RainbowLabsDE/PowerMeasure_1Ph/README.md

# PowerMeasure_1Ph

this repo is still undergoing major changes and should not yet be rebuilt
