RainbowLabsDE/PowerMeasure_1Ph/Doku/FrontpanelIdee.jpg

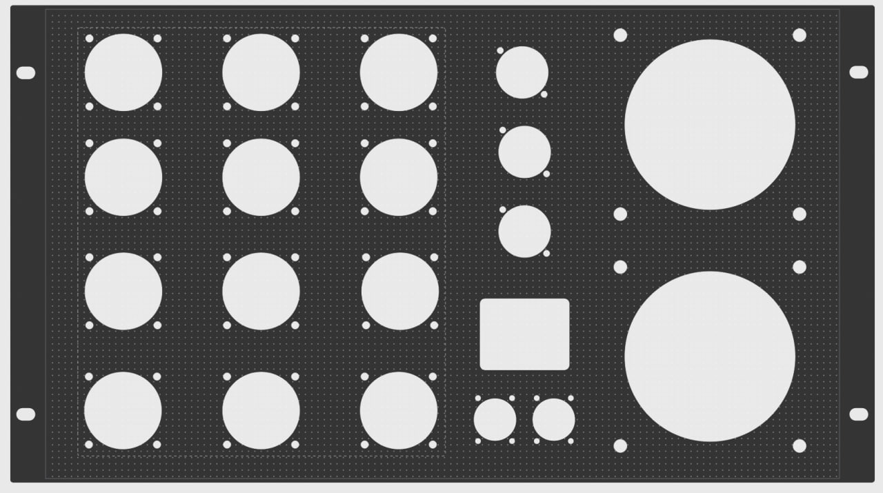
Doku/FrontpanelIdee.jpg
