RainbowLabsDE/PowerMeasure_1Ph/Hardware/PCB_umrissV3.dxf

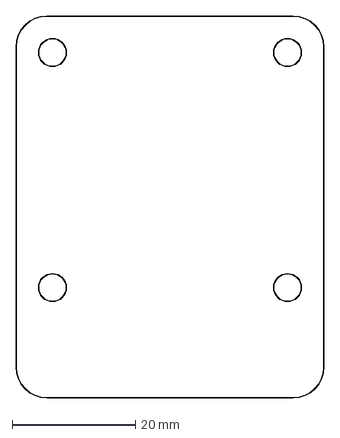
[picture p4: CAD file, 2024-11-22]
Hardware/PCB_umrissV3.dxf
50.0 x 62.0 mm
