RainbowLabsDE/PowerMeasure_1Ph/Mechanik/Plug-CEE-5pin-16A-Mannekes (Розетка типа CEE5pin 16A Female).IGS

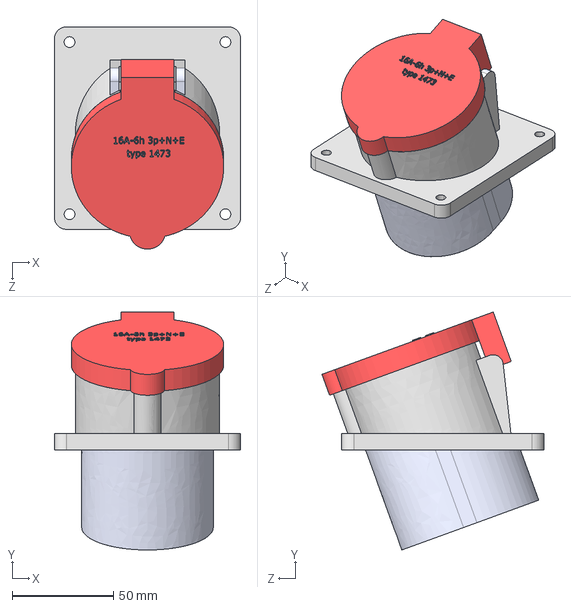
[picture p5: CAD file, 2024-11-22]
Mechanik/Plug-CEE-5pin-16A-Mannekes (Розетка типа CEE5pin 16A Female).IGS
92.0 x 117.5 x 109.7 mm
