RainbowLabsDE/PowerMeasure_1Ph/Hardware/ne8fbh-1.stp

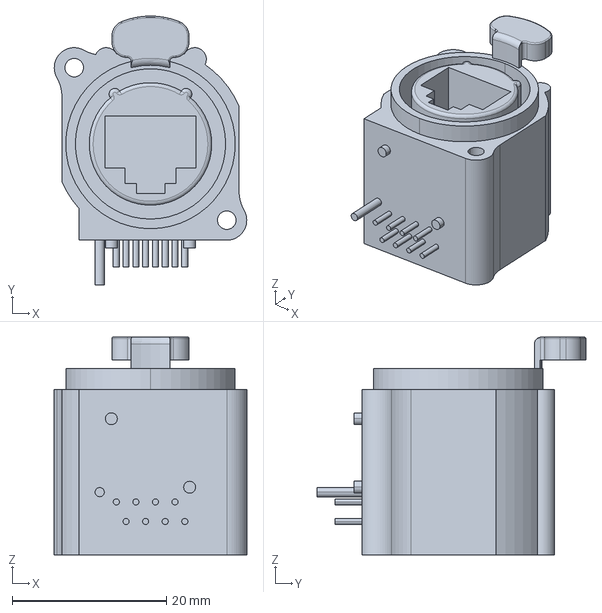
[picture p6: CAD file, 2024-11-22]
Hardware/ne8fbh-1.stp
25.0 x 34.9 x 28.3 mm
