RainbowLabsDE/PowerMeasure_1Ph/Mechanik/Einbaudose Typ 13 230V_10A IP54.STEP

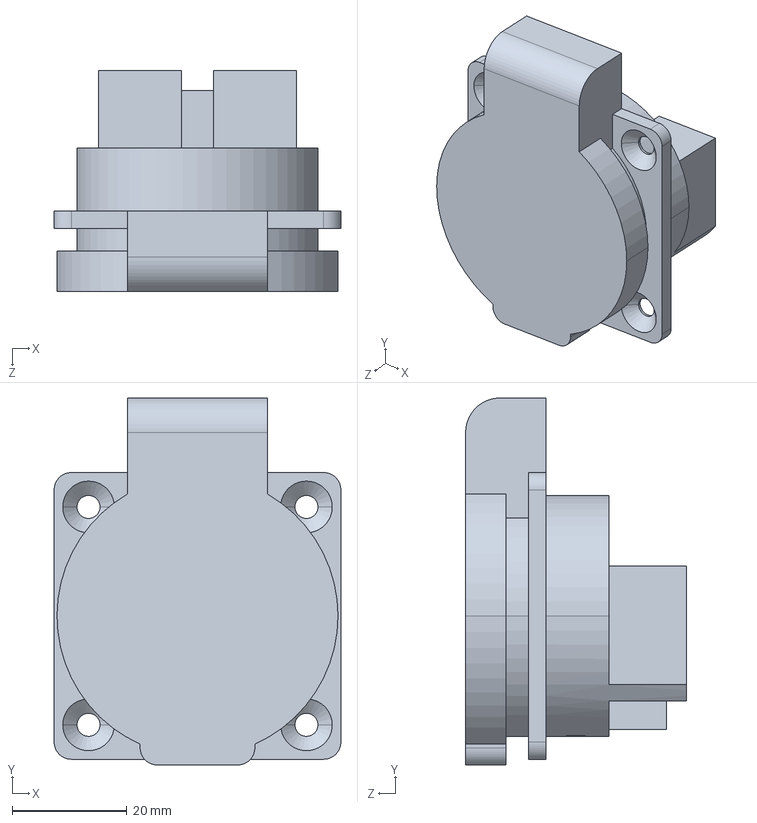
[picture p7: CAD file, 2024-11-22]
Mechanik/Einbaudose Typ 13 230V_10A IP54.STEP
50.0 x 64.0 x 38.5 mm
