RainbowLabsDE/PowerMeasure_1Ph/Mechanik/FI_LS_C13_30mA.STEP

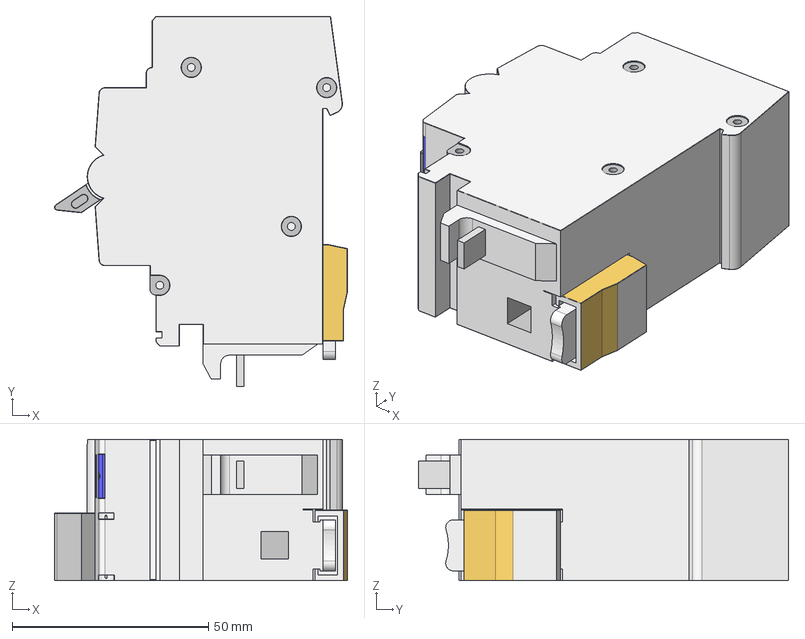
[picture p8: CAD file, 2024-11-22]
Mechanik/FI_LS_C13_30mA.STEP
74.6 x 94.3 x 36.0 mm
