RainbowLabsDE/PowerMeasure_1Ph/Hardware/NAC3FPX-WOT-TOP.stp

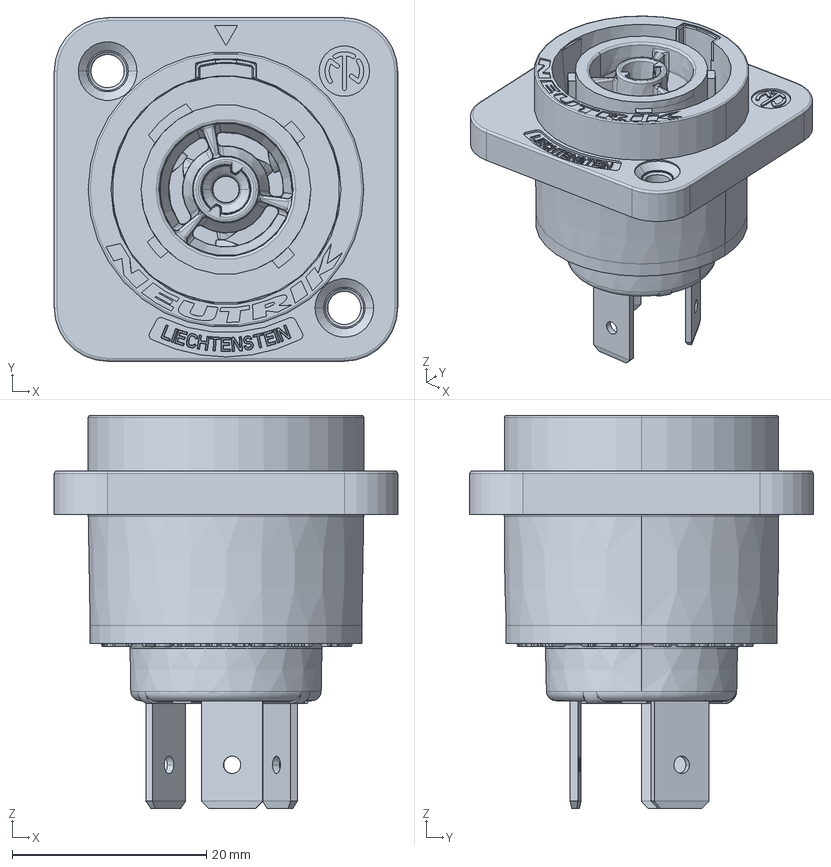
[picture p9: CAD file, 2024-11-22]
Hardware/NAC3FPX-WOT-TOP.stp
35.4 x 35.4 x 40.5 mm
