RainbowLabsDE/PowerMeasure_1Ph/Hardware/VAC v2.step

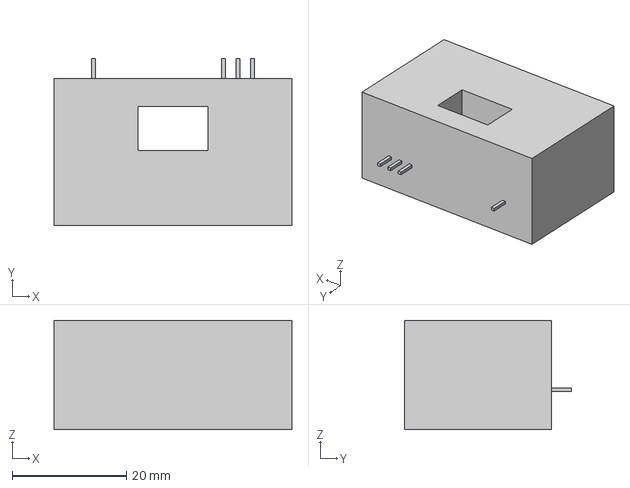
[picture p10: CAD file, 2024-11-22]
Hardware/VAC v2.step
41.8 x 29.3 x 19.2 mm
