RainbowLabsDE/PowerMeasure_1Ph/Hardware/Körper1.stl

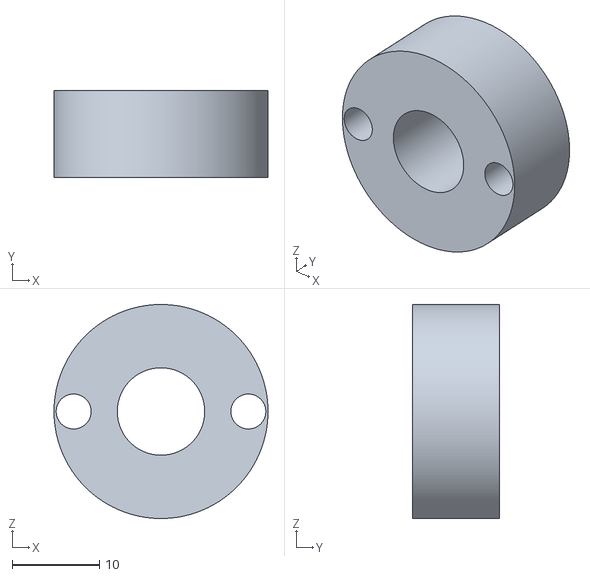
[picture p11: CAD file, 2024-11-22]
Hardware/Körper1.stl
24.5 x 10.0 x 24.5
