RainbowLabsDE/PowerMeasure_1Ph/Hardware/PCB_umriss.dxf

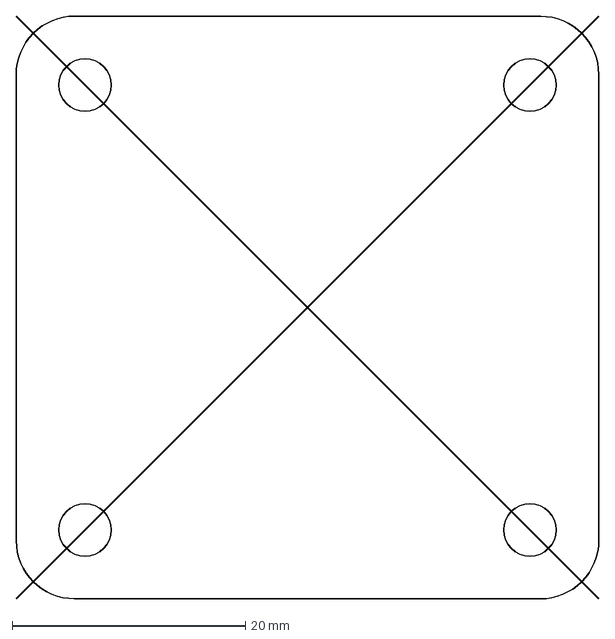
[picture p12: CAD file, 2024-11-22]
Hardware/PCB_umriss.dxf
50.0 x 50.0 mm
