RainbowLabsDE/PowerMeasure_1Ph/Hardware/EPR1200043B SSD1303 OLED bent 1.6mm.step

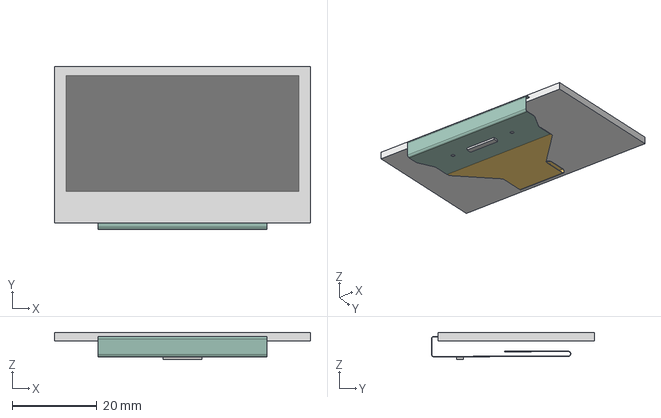
[picture p13: CAD file, 2024-11-22]
Hardware/EPR1200043B SSD1303 OLED bent 1.6mm.step
60.5 x 38.6 x 6.38 mm
