RainbowLabsDE/PowerMeasure_1Ph/Hardware/PCB_umrissV2.dxf

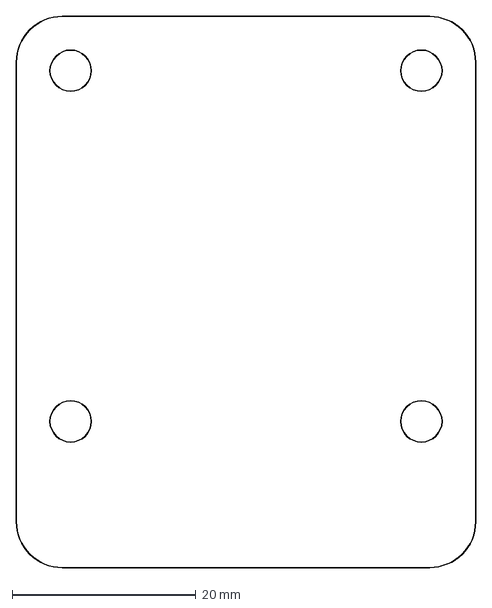
[picture p14: CAD file, 2024-11-22, an earlier design]
Hardware/PCB_umrissV2.dxf
50.0 x 60.0 mm
