RainbowLabsDE/PowerMeasure_1Ph/Hardware/Powermeter1P1I.kicad_pcb

## KiCad design Hardware/Powermeter1P1I.kicad_pcb (2025-05-22)

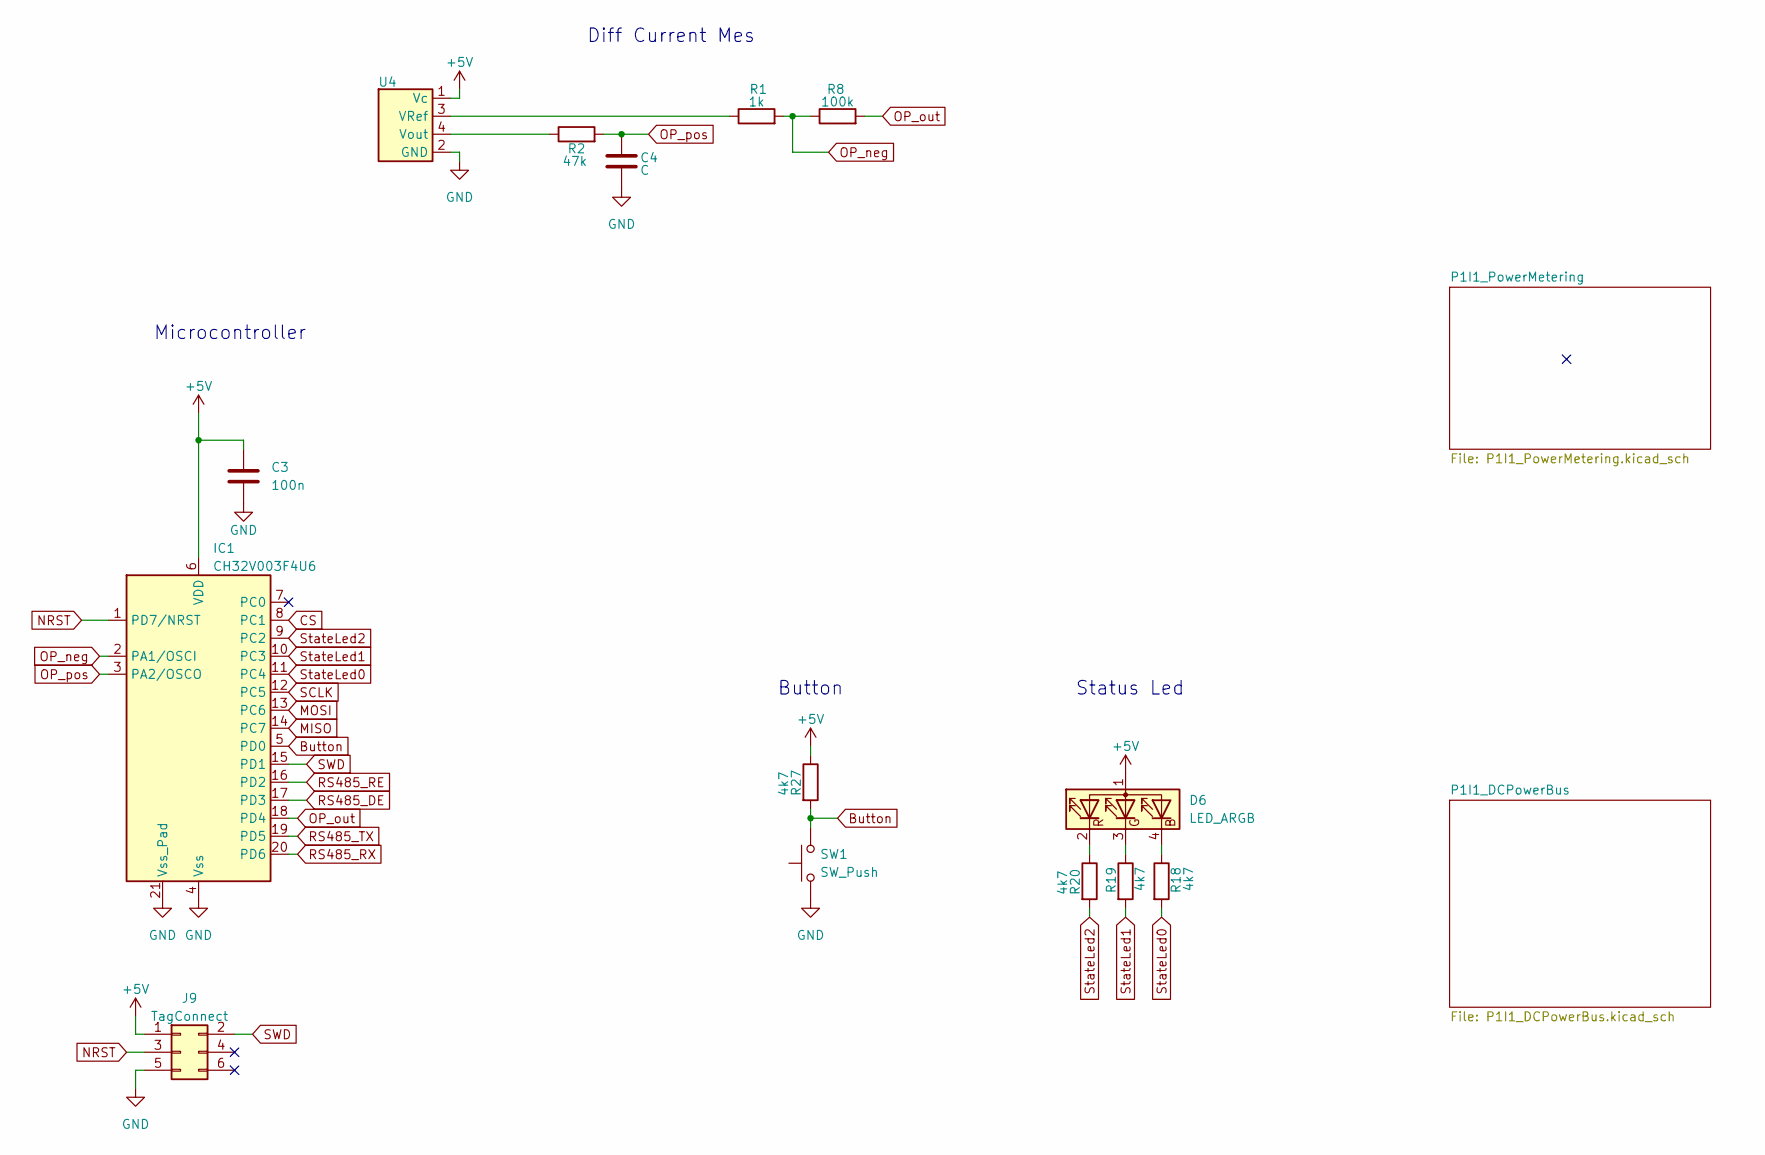
[picture p18: schematic Powermeter1P1I.kicad_sch]

Parts:
C3: 100n; C_0402_1005Metric
C4: C; C_0402_1005Metric
D6: LED_ARGB; LED-ARRAY-SMD_MHS110FRGBCT
IC1: CH32V003F4U6; QFN-20-1EP_3x3mm_P0.4mm_EP1.65x1.65mm_ThermalVias
J9: TagConnect; Tag-Connect_TC2030-IDC-NL_2x03_P1.27mm_Vertical
R1: 1k; R_0402_1005Metric
R2: 47k; R_0402_1005Metric
R8: 100k; R_0402_1005Metric
R18, R19, R20, R27: 4k7; R_0402_1005Metric
SW1: SW_Push; SW-SMD_TS24CA
U4: VACDiff

Connections:
+5V: C3.1, D6.1 (A), IC1.6 (VDD), J9.1, R27.1, U4.1 (Vc); also elsewhere on the board
Button: IC1.5 (PD0), R27.2, SW1.2
CS: IC1.8 (PC1); also elsewhere on the board
GND: C3.2, C4.2, IC1.4 (Vss), IC1.21 (Vss_Pad), J9.5, SW1.1, U4.2 (GND); also elsewhere on the board
MISO: IC1.14 (PC7); also elsewhere on the board
MOSI: IC1.13 (PC6); also elsewhere on the board
NRST: IC1.1 (PD7/NRST), J9.3
unnamed: D6.4 (BK), R18.1
unnamed: D6.3 (GK), R19.1
unnamed: D6.2 (RK), R20.1
unnamed: R1.1, U4.3 (VRef)
unnamed: R2.1, U4.4 (Vout)
OP_neg: IC1.2 (PA1/OSCI), R1.2, R8.1
OP_out: IC1.18 (PD4), R8.2
OP_pos: C4.1, IC1.3 (PA2/OSCO), R2.2
RS485_DE: IC1.17 (PD3); also elsewhere on the board
RS485_RE: IC1.16 (PD2); also elsewhere on the board
RS485_RX: IC1.20 (PD6); also elsewhere on the board
RS485_TX: IC1.19 (PD5); also elsewhere on the board
SCLK: IC1.12 (PC5); also elsewhere on the board
SWD: IC1.15 (PD1), J9.2
StateLed0: IC1.11 (PC4), R18.2
StateLed1: IC1.10 (PC3), R19.2
StateLed2: IC1.9 (PC2), R20.2

Notes on the sheet:
Status Led
Microcontroller
Button
Diff Current Mes

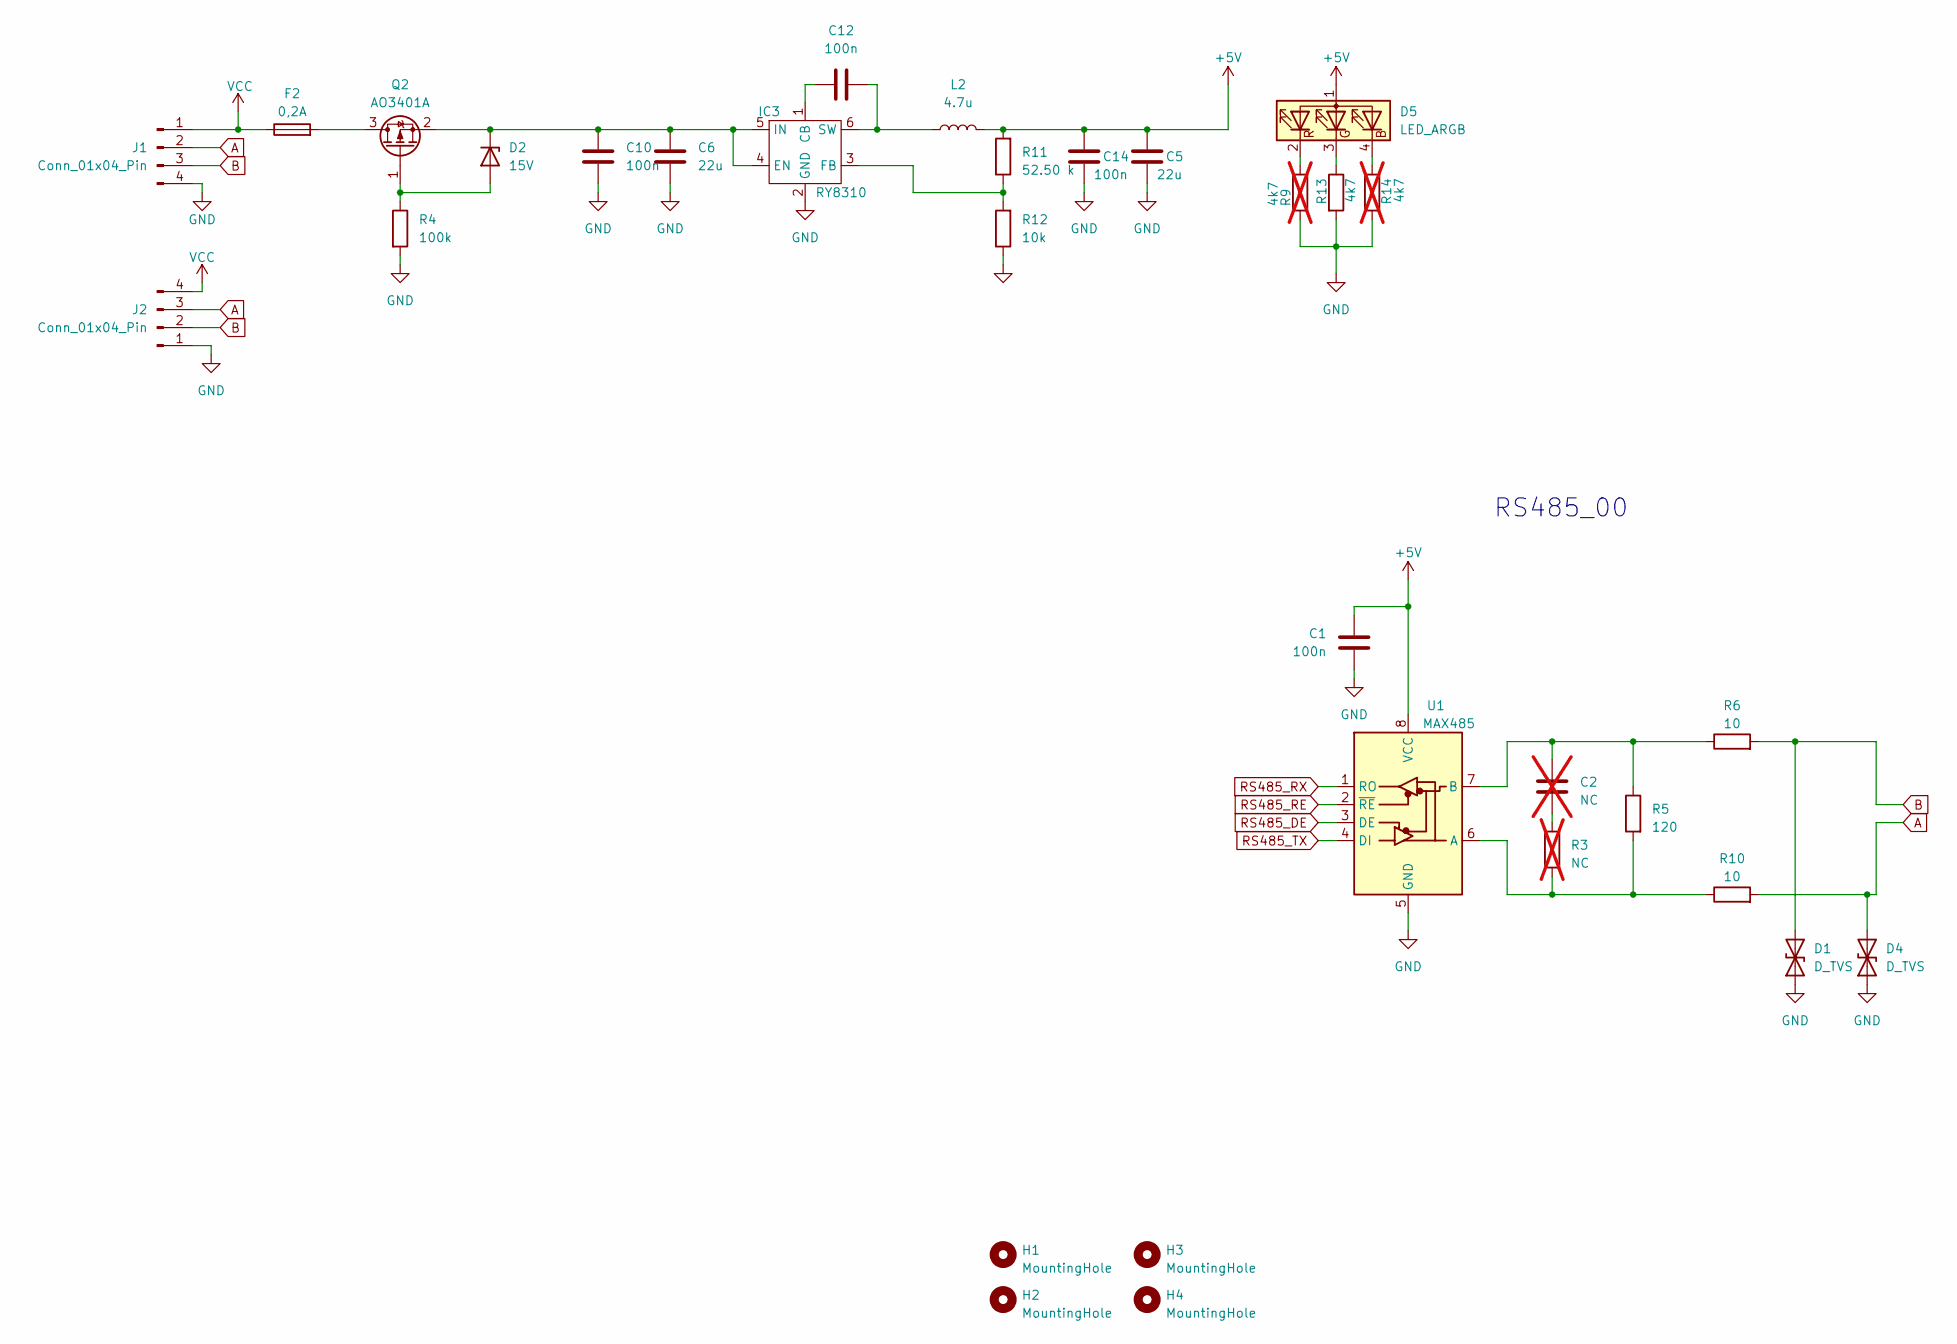
[picture p19: schematic P1I1_DCPowerBus.kicad_sch]

Parts:
C1, C10, C12, C14: 100n; C_0402_1005Metric
C2: NC; C_0402_1005Metric; not fitted
C5, C6: 22u; C_1210_3225Metric
D1, D4: D_TVS; D_0402_1005Metric
D2: 15V; D_SOD-323
D5: LED_ARGB; LED-ARRAY-SMD_MHS110FRGBCT
F2: 0,2A; Fuse_0603_1608Metric
H1, H2, H3, H4: MountingHole; MountingHole_4.3mm_M4
IC3: RY8310; SOT-23-6
J1, J2: Conn_01x04_Pin; CONN-SMD_HCZZ0451-4
L2: 4.7u; IND-SMD_L2.0-W1.6
Q2: AO3401A; TSOT-23
R3: NC; R_0402_1005Metric; not fitted
R4: 100k; R_0402_1005Metric
R5: 120; C_0402_1005Metric
R6, R10: 10; R_1206_3216Metric
R9, R14: 4k7; R_0402_1005Metric; not fitted
R11: 52.50 k; R_0402_1005Metric
R12: 10k; R_0402_1005Metric
R13: 4k7; R_0402_1005Metric
U1: MAX485; SOIC-8_3.9x4.9mm_P1.27mm

Connections:
+5V: C1.1, C5.1, C14.1, D5.1 (A), L2.2, R11.2, U1.8 (VCC); also elsewhere on the board
A: D4.2 (A2), J1.2, J2.3, R10.2
B: D1.2 (A2), J1.3, J2.2, R6.2
GND: C1.2, C5.2, C6.2, C10.2, C14.2, D1.1 (A1), D4.1 (A1), IC3.2 (GND), J1.4, J2.1, R4.2, R9.2, R12.1, R13.2, R14.2, U1.5 (GND); also elsewhere on the board
unnamed: C2.2, R3.2
unnamed: D2.2 (A), Q2.1 (G), R4.1
unnamed: C6.1, C10.1, D2.1 (K), IC3.4 (EN), IC3.5 (IN), Q2.2 (S)
unnamed: D5.4 (BK), R14.1
unnamed: D5.3 (GK), R13.1
unnamed: D5.2 (RK), R9.1
unnamed: C12.1, IC3.1 (CB)
unnamed: IC3.3 (FB), R11.1, R12.2
unnamed: C12.2, IC3.6 (SW), L2.1
unnamed: F2.2, Q2.3 (D)
unnamed: R3.1, R5.2, R10.1, U1.6 (A)
unnamed: C2.1, R5.1, R6.1, U1.7 (B)
RS485_DE: U1.3 (DE); also elsewhere on the board
RS485_RE: U1.2 (~RE); also elsewhere on the board
RS485_RX: U1.1 (RO); also elsewhere on the board
RS485_TX: U1.4 (DI); also elsewhere on the board
VCC: F2.1, J1.1, J2.4

Notes on the sheet:
RS485_00

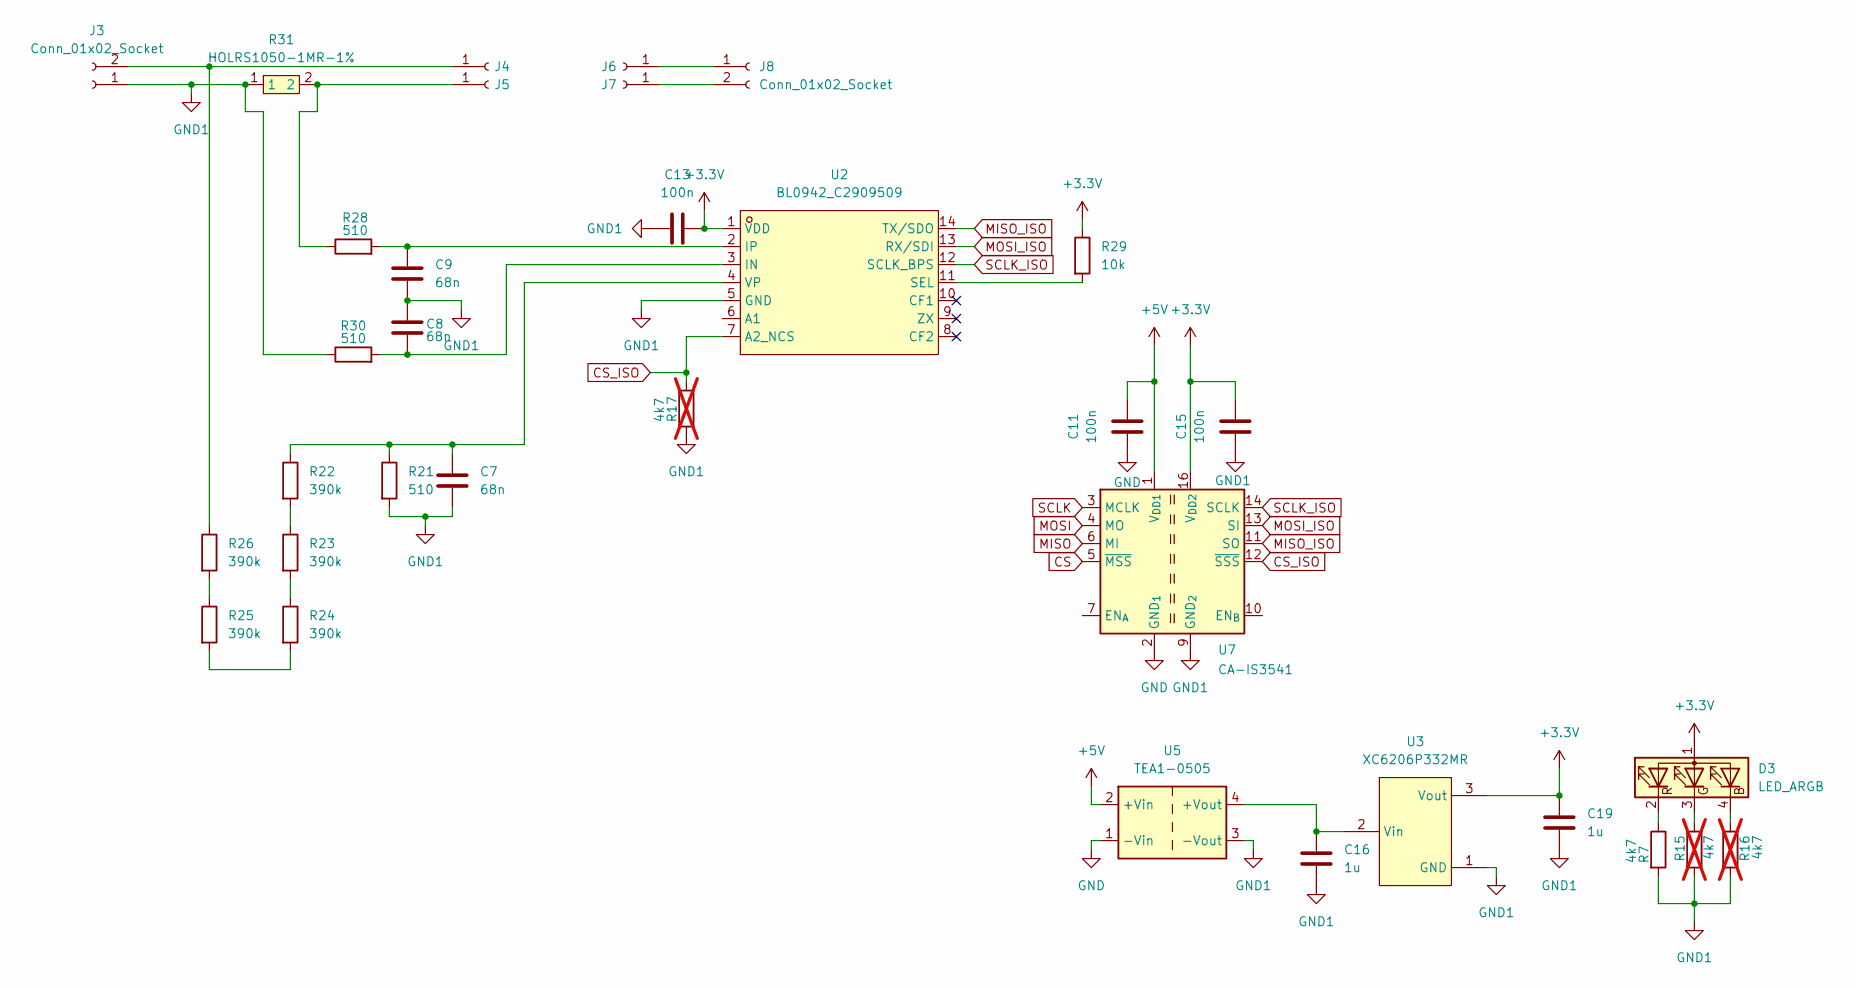
[picture p20: schematic P1I1_PowerMetering.kicad_sch]

Parts:
C7, C8, C9: 68n; C_0402_1005Metric
C11, C13, C15: 100n; C_0402_1005Metric
C16, C19: 1u; C_0402_1005Metric
D3: LED_ARGB; LED-ARRAY-SMD_MHS110FRGBCT
J3, J8: Conn_01x02_Socket; LPT2,5-2-5,0
J4, J5, J6, J7: Conn_01x01_Socket; TestPoint_THTPad_3.0x3.0mm_Drill1.5mm
R7: 4k7; R_0402_1005Metric
R15, R16, R17: 4k7; R_0402_1005Metric; not fitted
R21, R28, R30: 510; R_0603_1608Metric
R22, R23, R24, R25, R26: 390k; R_0603_1608Metric
R29: 10k; R_0402_1005Metric
R31: HOLRS1050-1MR-1%; R3920; LCSC Part C481472
U2: BL0942_C2909509; TSSOP-14_L5.0-W4.4-P0.65-LS6.4-BL; LCSC Part C2909509
U3: XC6206P332MR; SOT-23-3_L2.9-W1.6-P1.90-LS2.8-BR; LCSC Part C5446
U5: TEA1-0505; Converter_DCDC_TRACO_TEA1-xxxx_THT
U7: CA-IS3541; SOIC-16W_7.5x10.3mm_P1.27mm

Connections:
+3.3V: C13.2, C15.2, C19.1, D3.1 (A), R29.1, U2.1 (VDD), U3.3 (Vout), U7.16 (V_{DD2})
+5V: C11.2, U5.2 (+Vin), U7.1 (V_{DD1}); also elsewhere on the board
CS: U7.5 (~MSS); also elsewhere on the board
CS_ISO: R17.1, U2.7 (A2_NCS), U7.12 (~SSS)
GND: C11.1, U5.1 (-Vin), U7.2 (GND_{1}), U7.8 (GND_{1}); also elsewhere on the board
GND1: C7.2, C8.1, C9.2, C13.1, C15.1, C16.2, C19.2, J3.1, R7.2, R15.2, R16.2, R17.2, R21.2, R30.1, R31.1, U2.5 (GND), U3.1 (GND), U5.3 (-Vout), U7.9 (GND_{2}), U7.15 (GND_{2})
MISO: U7.6 (MI); also elsewhere on the board
MISO_ISO: U2.14 (TX/SDO), U7.11 (SO)
MOSI: U7.4 (MO); also elsewhere on the board
MOSI_ISO: U2.13 (RX/SDI), U7.13 (SI)
unnamed: D3.4 (BK), R16.1
unnamed: D3.3 (GK), R15.1
unnamed: D3.2 (RK), R7.1
unnamed: J3.2, J4.1, R26.1
unnamed: J5.1, R28.1, R31.2
unnamed: J6.1, J8.1
unnamed: J7.1, J8.2
unnamed: R22.2, R23.1
unnamed: R23.2, R24.1
unnamed: R24.2, R25.2
unnamed: R25.1, R26.2
unnamed: C8.2, R30.2, U2.3 (IN)
unnamed: C9.1, R28.2, U2.2 (IP)
unnamed: R29.2, U2.11 (SEL)
unnamed: C7.1, R21.1, R22.1, U2.4 (VP)
unnamed: C16.1, U3.2 (Vin), U5.4 (+Vout)
SCLK: U7.3 (MCLK); also elsewhere on the board
SCLK_ISO: U2.12 (SCLK_BPS), U7.14 (SCLK)

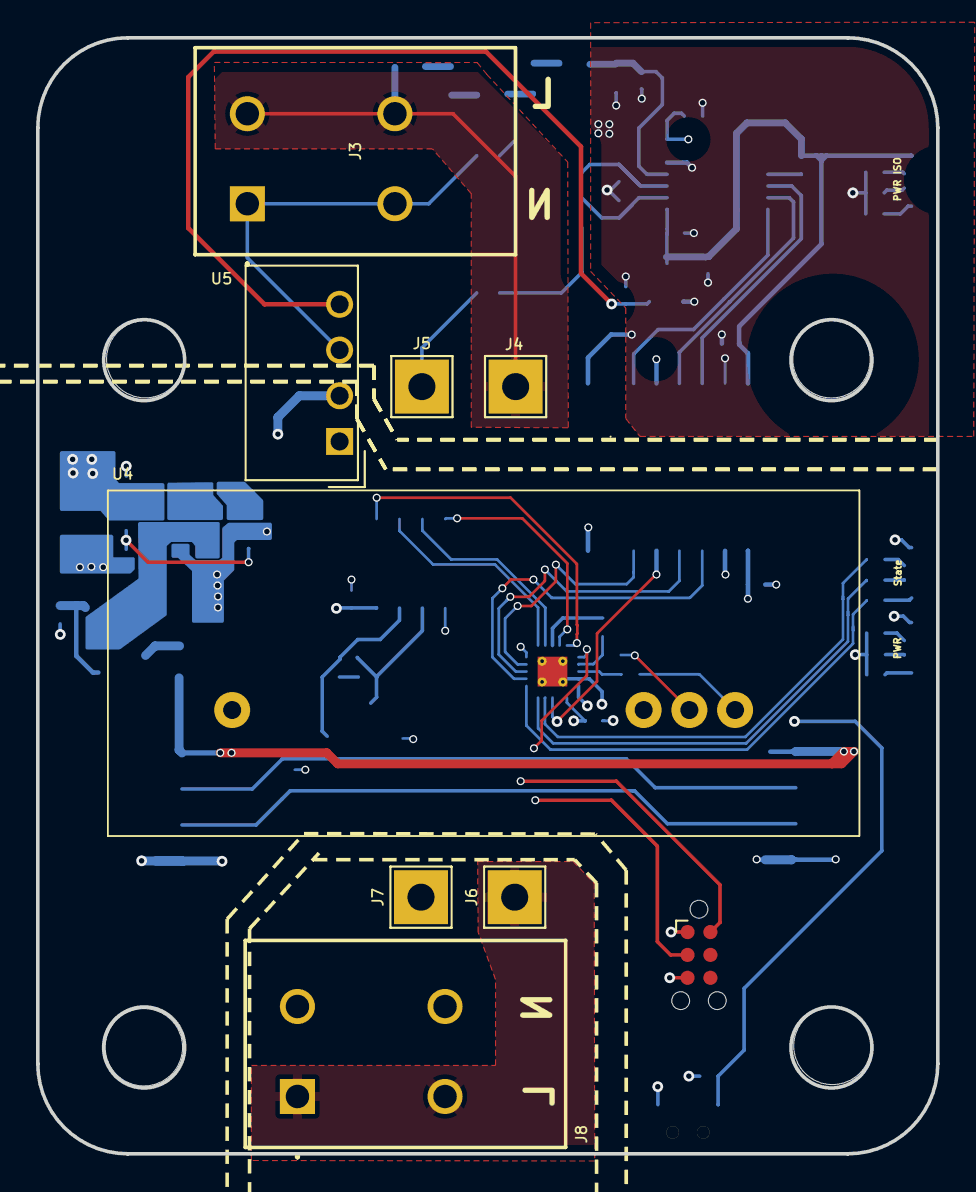
[picture p21: board Powermeter1P1I.kicad_pcb from above]

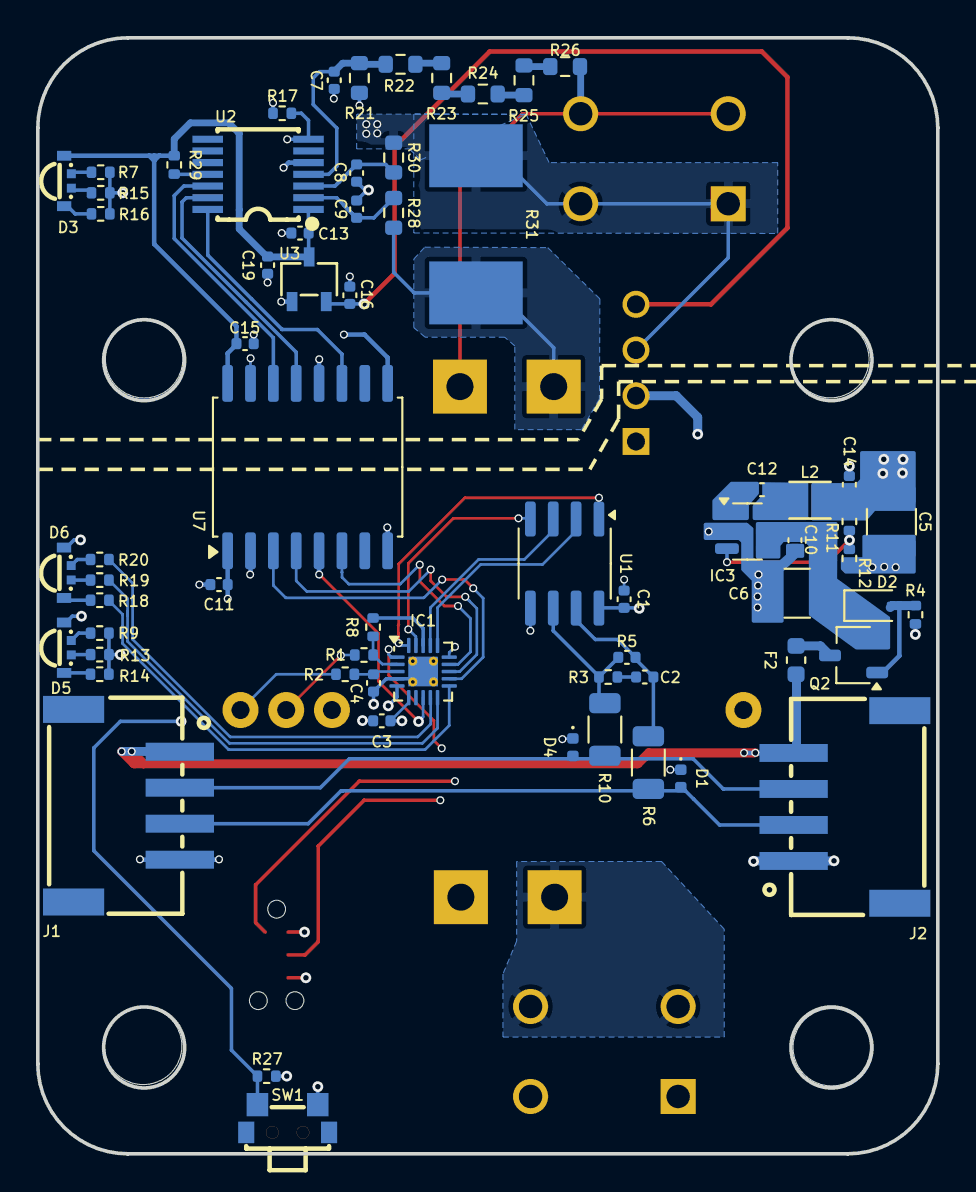
[picture p22: board Powermeter1P1I.kicad_pcb from below]

Board: 4 copper layers, 50.0 x 62.0 mm, 79 parts (66 on the bottom side), 61 nets.
