RainbowLabsDE/PowerMeasure_1Ph/(commit log)

2024-11-22 add Schematic PDF
2025-02-13 add all
    [P1I1_DCPowerBus.kicad_sch, P1I1_PowerMetering.kicad_sch, Powermeter1P1I.kicad_pcb, Powermeter1P1I.kicad_sch]
2025-02-13 fix Silkscreen
    [Powermeter1P1I.kicad_pcb]
2025-02-13 isolation slot and silkscreen tweaks
    [P1I1_PowerMetering.kicad_sch, Powermeter1P1I.kicad_pcb]
2025-05-22 add spi and BL0942
2025-05-22 fix SPI & BL0942 communication
    [BL0942.cpp, BL0942.h, main.cpp, spi.cpp, spi.h]
2025-05-23 fix delay() not working, when using SDI Print
    [main.cpp, util.cpp, util.h]
2025-06-05 add workaround for SDI printf bug
